xuqi2024/openflexure-microscope/docs/2a_basic_optics_module_zh.md

# 基础光学模块
显微镜光学系统最简单的选择是使用网络摄像头镜头。这是摄影师的老技巧，将广角镜头反向使用作为微距镜头，所以原本指向相机传感器的一侧现在指向样品。因为网络摄像头有非常小的像素，反向使用网络摄像头制作了相当好的显微镜物镜。这个版本的光学模块将树莓派相机变成一个视野约400微米、分辨率约2微米的显微镜。

# 需求
您需要下图中显示的零件：

此步骤所需的零件

## 零件
*   1个[相机平台](./parts/printed/camera_platform.md)
*   1个[镜头延长管](./parts/printed/lens_spacer.md)
*   1个[树莓派相机模块](./parts/electronics/raspberry_pi_camera.md)（理想情况下是v2，尽管v1也应该可以工作） - 您可以用6-LED网络摄像头替代以获得更低成本的解决方案。
*   1个[M3钢螺母](./parts/fixings/m3_steel_nut.md)
*   1个[M3x10mm内六角螺钉](./parts/fixings/m3x8mm_caphead_screw.md)
*   2个[M2x6mm内六角螺钉](./parts/fixings/m2x6mm_caphead_screw.md)

## 工具
*   1个2.5mm内六角扳手
*   1个1.5mm内六角扳手
*   1个手术刀或工艺刀（可选）
*   1个镜头移除工具（相机随附）
*   1个打印的[电路板夹具](./parts/printed_tools/picamera_2_tools.md)

# 组装说明
## 步骤1
首先，获取必要的工具和零件：光学模块塑料零件（镜头间隔器和相机平台）、树莓派相机模块、移除相机镜头的工具、两个M2螺钉来固定相机。根据打印质量，您可能还需要锋利的工艺刀或一些胶带。
 
注意镜头移除工具、电路板夹具和光学模块都特定于您使用的相机。此版本的说明适用于相机板的版本2，树莓派相机模块的版本1也可以工作，但您需要用钳子或镊子移除镜头。相机模块版本2附带镜头移除工具，这是一个中心有孔的白色塑料圆盘。如果可用，这比打印的镜头移除工具更好。

如果您使用6-LED USB网络摄像头（在eBay或AliExpress上约3英镑），您需要跳过其中一些步骤，还要拆解塑料外壳以提取相机的电路板。您可以简单地拧下网络摄像头镜头并将其倒置胶带或粘贴到固定在电路板上的支架上。构建中有6-LED相机的相机平台STL，用它替代树莓派相机平台零件。

## 步骤2
我们需要从相机中移除镜头。为此，您需要两个塑料工具（电路板夹具和镜头移除器）以及相机模块。最好确保您在移除镜头之前已完成到此为止的步骤，以最小化传感器暴露在空气和灰尘中的时间。

> **警告！** 相机板对静电敏感。采取通常的防静电预防措施（理想情况下使用连接到地的防静电腕带，但至少确保在操作相机模块之前触摸接地对象，如金属管道）。

## 步骤3
从相机镜头上移除保护膜。

从镜头上移除保护膜

## 步骤4
有一根小带状电缆连接相机和PCB，很容易断裂。有一个方形塑料夹具适合放在相机和PCB上（"相机板夹具"），防止相机扭转并损坏带状电缆。如图所示将其安装在相机上。请注意，相机板v2的零件多少能适配v1，但您需要更小心，因为它不是完美契合。

电路板夹具
夹住相机以防止带状电缆损坏

## 步骤5
接下来，从相机模块拧下镜头。使用塑料工具夹住镜头模块。这是一个小圆形零件，有四个叉，如图所示适合放在相机板镜头上（仅限版本2）。要移除镜头，将移除工具推到镜头上（只是顶部，有小塑料凸缘的部分）并逆时针转动移除。
 
打印工具只有在叉指向逆时针方向时才有效，所以确保方向正确。重要的是使用电路板夹具固定相机芯片并防止损坏精细的带状电缆。移除镜头后，检查连接相机模块（您拧下镜头的黑色塑料方块）到PCB的小黑色或橙色带状电缆是否仍然连接 - 如果需要，用手指推它重新连接。

移除镜头后，确保将相机面朝下放在桌子上，或在方形黑色镜头支架上贴一条胶带；这将有助于防止灰尘沉积在传感器上，这极难清洁。

镜头移除

## 步骤6
在将零件组装到支架中之前，通过吹一些空气确保其无尘，并检查安装座中央孔中没有塑料丝。

## 步骤7
接下来，将镜头放入塑料延长管中。镜头应该放入时，靠近相机传感器的一侧在上面，面向外的一侧（黑色塑料中有小孔的一侧）面向延长管内。这应该只是推入配合，但可能需要一点力，或需要在镜头周围缠绕一层胶带使其紧密配合（取决于您的打印机）。如果您在镜头周围缠绕胶带，用手术刀或锋利的工艺刀修剪掉伸出镜头上方的任何胶带。

延长管中的镜头



## 步骤8
将延长管安装到相机板上，然后将相机板和延长管放到相机平台上。用两个M2螺钉固定就位，螺钉穿过延长管和相机板，进入平台。如果有的话，您可以使用另外两个M2螺钉使连接更牢固。



## 步骤9
将螺母滑入相机平台侧面的螺母槽中。这可能不需要工具，但您可以使用2.5mm内六角扳手推入。



## 步骤10
将M3螺钉拧入螺母，使其从相机平台侧面伸出。


## 步骤11
做得好 - 您已经组装了光学模块。
