xuqi2024/openflexure-microscope/docs/mount_optics_and_microscope.md

# Mount the optics and the microscope

{{BOM}}

[2.5mm Ball-end Allen key]: parts/tools/2.5mmBallEndAllenKey.md

## Mount the optics {pagestep}






* Get the [2.5mm Ball-end Allen key]{qty:1, cat:tool} ready
* Take the [complete optics module](fromstep){qty:1, cat:subassembly} and pass it through the bottom of the [microscope][microscope with assembled actuators](fromstep){qty:1, cat:subassembly}.
* Insert exposed the mounting screw on the optics module through the keyhole on the z-actuator.






* Insert the Allen key through the teardrop shaped hole on the front of the microscope. Until it engages with the mounting screw.
* Slide optics module up the keyhole as high as it will go.
* Tighten the screw with the Allen key to lock the optics in place.

{{include: mount_microscope.md}}
