xuqi2024/openflexure-microscope/docs/prepare_stand.md

# Prepare the microscope stand

{{BOM}}

[2.5mm Ball-end Allen key]: parts/tools/2.5mmBallEndAllenKey.md
[M3 nut]: parts/mechanical.yml#Nut_M3_SS

## Embed mounting nut in the stand {pagestep}




* Take the [microscope stand][Microscope stand](fromstep){qty:1, cat:printedpart}
* Place an [M3 nut]{qty:4, cat:mech} in the slot under a mounting lug
* Put an [M3x10 cap head screw][extra M3x10 cap screw](parts/mechanical.yml#CapScrew_M3x10mm_SS){qty: 1, cat:tool} into the hole above the nut
* Tighten with a [2.5mm Ball-end Allen key]{qty:1, cat:tool} until you feel reasonable resistance
* Unscrew and remove the screw. The nut should stay mounted.

## Embed remaining mounting nuts in the stand {pagestep}





Repeat the above process for the other three mounting lugs

[prepared microscope stand]{output, qty:1, hidden}
