xuqi2024/openflexure-microscope/docs/high_res_microscope.md

#High-resolution microscope

This is the standard research version of the OpenFlexure Microscope. It supports Standard RMS threaded objectives. It is a fully functioning motorised laboratory grade microscope. For more information on the microscope and its performance [see our paper in Optics Express](https://doi.org/10.1364/BOE.385729).

If you use this microscope for research please consider citing this paper.

Before you start building the microscope you will need to source all the components listed our [bill of materials]{bom}.

The assembly is broken up into several steps:

1. [.](test_your_printer.md){step}
1. [.](printing.md){step, var_type: high_res}
1. [.](solder_led.md){step}
1. [.](prepare_main_body.md){step}
1. [.](prepare_stand.md){step}
1. [.](actuator_assembly.md){step}
1. [.](high_res_optics_module.md){step}
1. [.](mount_optics_and_microscope.md){step}
1. [.](illumination.md){step}
1. [.](motors.md){step}
1. [.](attach_clips.md){step}
1. [.](wiring.md){step}
