xuqi2024/openflexure-microscope/docs/z_motor.md

## Attach the z motor {pagestep}




* Attach the motor to the z-actuator in the same way as they x and y actuators
* Feed the motor cable down the rectangular slot to the left of the actuator.
