xuqi2024/openflexure-microscope/QUICK_START.md

# OpenFlexure显微镜项目快速理解指南

## 🔬 项目是什么？
OpenFlexure显微镜是一个**开源3D打印显微镜项目**，让任何人都能制造高质量的科学显微镜。

## ⭐ 核心特点
- **低成本**: 主要部件为3D打印，成本极低
- **高精度**: 达到亚微米级定位精度（<100nm）
- **模块化**: 可根据需求选择不同的光学系统和功能
- **开源**: 完全开放的硬件和软件设计

## 🎯 适用场景
- **教育**: 学校实验室、科学教育
- **研究**: 生物学、材料学研究
- **医疗**: 基础医疗诊断（特别是发展中国家）
- **业余**: 个人爱好者的科学探索

## 📦 三种配置方案

### 1. 基础版（教育用）💡
- **成本**: ~$100-200
- **光学**: 树莓派相机 + 简单镜头
- **控制**: 手动调节
- **适用**: 学生实验、基础观察

### 2. 标准版（通用）🔧
- **成本**: ~$300-500  
- **光学**: 树莓派相机 + RMS显微镜物镜
- **控制**: 电机自动化
- **适用**: 科研实验、精密观察

### 3. 专业版（研究用）🎯
- **成本**: ~$500-1000
- **光学**: 高质量物镜 + 荧光功能
- **控制**: 全自动化 + 远程控制
- **适用**: 专业研究、医疗诊断

## 🛠️ 制造所需

### 3D打印部件（约200g塑料）
- PLA材料推荐
- 标准FDM打印机即可
- 无需支撑材料

### 电子部件
- 树莓派4B + SD卡
- 树莓派相机模块
- 步进电机（可选）
- LED照明
- 各种螺钉螺母

### 工具
- 基本手工工具
- 螺丝刀套装
- 精密镊子

## 🏗️ 项目结构一览

```
openflexure-microscope/
├── 📁 openscad/           # 3D设计源文件（OpenSCAD）
├── 📁 docs/               # 详细组装说明
├── 📁 build_system/       # 自动构建系统
├── 📄 build.py           # 一键构建脚本
├── 📄 ARCHITECTURE.md    # 详细技术文档
└── 📄 README.md          # 项目说明
```

## 🚀 快速开始

### 1. 获取STL文件
访问 [STL配置器](https://microscope-stls.openflexure.org) 选择配置并下载打印文件

### 2. 3D打印部件
按照 `docs/0_printing.md` 的说明打印所有部件

### 3. 采购电子部件
参考 `docs/0_bill_of_materials.md` 购买所需电子元件

### 4. 组装显微镜
按照 `docs/` 目录中的组装指南逐步组装

### 5. 安装软件
安装树莓派系统和OpenFlexure控制软件

## 🔧 核心技术原理

### 柔性机构
- 不使用传统的轴承和导轨
- 通过塑料的弹性变形实现精密运动
- 无摩擦、无间隙、高精度

### 3D打印一体化
- 复杂的机械结构一次打印成型
- 减少组装工作和成本
- 提高整体结构稳定性

### 模块化设计
- 光学系统可互换
- 支持从网络摄像头到专业物镜
- 可扩展照明、滤光等功能

## 🌐 社区与支持

### 官方资源
- **网站**: [openflexure.org](https://openflexure.org)
- **论坛**: [openflexure.discourse.group](https://openflexure.discourse.group)
- **代码**: [GitLab](https://gitlab.com/openflexure)

### 相关项目
- **控制软件**: OpenFlexure Microscope Server
- **客户端**: OpenFlexure Connect
- **硬件**: Sangaboard电机控制板

## 📚 进一步学习

1. **阅读架构文档**: `ARCHITECTURE.md` - 深入了解技术细节
2. **查看组装视频**: 官网提供详细的组装教程
3. **加入社区**: 论坛和聊天群获取帮助
4. **贡献项目**: 提交改进建议或新功能

## 💡 为什么选择OpenFlexure？

- **经济实用**: 成本是商业显微镜的1/10到1/100
- **性能优异**: 精度达到商业产品水平
- **完全开放**: 可自由修改和定制
- **社区支持**: 活跃的全球开发者社区
- **教育价值**: 在制造过程中学习光学和机械原理

---

这个项目代表了开源硬件在科学仪器领域的一个里程碑，它证明了通过合作和开放可以让先进的科学工具普及到世界各地。
