xuqi2024/openflexure-microscope/docs/_navigation_zh.md

# OpenFlexure显微镜中文文档导航

## 组装指南
1. [主页](./index_zh.md) - 项目介绍和总览
2. [材料清单](./0_bill_of_materials_zh.md) - 获取非打印零件
3. [打印零件](./0_printing_zh.md) - 3D打印指南和设置
4. [致动器组装](./1_actuator_assembly_zh.md) - 组装运动机制
5. [基础光学模块](./2a_basic_optics_module_zh.md) - 网络摄像头光学系统
6. [照明系统](./3_illumination_zh.md) - 透射照明组装

## 待翻译文档
- `2b_high_resolution_optics_module.md` - 高分辨率光学模块
- `3b_illumination_reflection.md` - 反射照明
- `4_clips_and_wiring.md` - 样品夹具和布线
- `5_motors.md` - 电机安装
- `6_motor_controllers.md` - 电机控制板

## 英文原版文档
如需查看英文原版，请参考 `docs/` 目录下对应的文件。

## 构建类型选择

### 基础版本（教育用）
- 使用 `2a_basic_optics_module_zh.md` 中的说明
- 适合学校和业余爱好者
- 成本最低，分辨率约2微米

### 高分辨率版本（研究用）  
- 使用高分辨率光学模块（待翻译）
- 适合科学研究和医疗应用
- 需要显微镜物镜和管镜

### 电机化版本
- 在基础版本基础上添加电机系统
- 支持自动控制和远程操作
- 需要额外的电机和控制板

## 帮助和支持
- [GitHub仓库](https://github.com/rwb27/openflexure_microscope)
- [官方论坛](https://openflexure.discourse.group/)
- [官方网站](https://openflexure.org/)

---
*这些中文文档是英文原版的翻译，如有疑问请以英文原版为准。*
