xuqi2024/openflexure-microscope/docs/0_bill_of_materials_zh.md

# 获取非打印零件
确保在开始之前您拥有所有必要的零件和工具。所有零件都应在下面的材料清单中列出，目前这个清单仍在完善中（最终将自动生成，这应该有助于保持准确性）。我们建议通读所有说明并检查此处显示的数量是否正确相加，直到自动生成功能正常工作。打印零件在[下一节](./0_printing_zh.md)中描述。

## 固定硬件：
*   3x [M3x25mm六角头螺钉](./parts/fixings/m3x25mm_hexagonhead_screw.md)，不锈钢
*   3x [M3黄铜螺母](./parts/fixings/m3_brass_nut.md)
*   1x [M3钢螺母](./parts/fixings/m3_steel_nut.md)（使用黄铜也可以）
*   8x [M3不锈钢垫圈](./parts/fixings/m3_washer.md)
*   3-14x [M3x8mm内六角螺钉](./parts/fixings/m3x8mm_caphead_screw.md)（有些是可选的，用于样品夹具和样品升高器，但您至少需要三个）
*   2-4x [M2x6mm内六角螺钉](./parts/fixings/m2x6mm_caphead_screw.md)
*   6x [M4x6mm盘头螺钉](./parts/fixings/m4x6mm_buttonhead_screw.md)（可选，用于电机）
*   3x [氟橡胶O型圈，30x2mm](./parts/fixings/viton_o_ring_30mm_inner_diameter_2mm_cross_section.md)（注意：多准备一些备用件！）

## 电子零件：
*   [5mm白色LED](./parts/electronics/white_led.md)
*   [60欧姆电阻](./parts/electronics/60_ohm_resistor.md)
*   [多股电线](./parts/electronics/stranded_wire.md)
*   [2路JST接头连接器](./parts/electronics/2_way_jst_header.md)（只要您有办法点亮LED，具体类型并不重要）
*   [树莓派相机模块](./parts/electronics/raspberry_pi_camera.md)（v2版本，虽然v1版本也可以）
*   [树莓派](./parts/electronics/raspberry_pi.md)（配套电源、键盘、显示器等）
*   3x [28BYJ-48微型步进电机](./parts/electronics/stepper_motors.md)（可选）
*   上述电机的[电机驱动板](./parts/electronics/motor_driver.md)（可选）

## 光学零件：
*   [13mm直径，5mm焦距塑料聚光镜](./parts/optics/condenser_lens.md)（可选，强烈推荐用于高分辨率光学系统）
*   [12.7mm直径，50mm焦距消色差透镜](./parts/optics/tube_lens.md)（仅用于高分辨率光学系统）
*   [RMS螺纹，有限共轭显微镜物镜](./parts/optics/objective.md)（仅用于高分辨率光学系统）

## 工具：
*   2.5mm内六角扳手
*   1.5mm内六角扳手（用M2螺钉固定相机时使用）
*   胶带（电工胶带或PTFE水管工胶带效果很好，尽管普通胶带也可以）
*   锋利的工艺刀（用于修剪胶带和清理打印件）
*   3mm钻头配手摇钻夹头（如果您自己打印零件并需要扩大孔径）
*   尖嘴钳（可选，但很有用 - 特别适合清理打印件）

不要忘记树莓派、相机模块和相关的屏幕、电源、SD卡、键盘、鼠标等（我没有明确列出这些，但运行树莓派需要它们）。另外，如果您使用高分辨率光学模块或想要添加电机，您将需要额外的零件。

在等待您订购的零件到达时，为什么不尝试下一节关于[打印塑料零件](./0_printing_zh.md)的内容呢。
