xuqi2024/openflexure-microscope/docs/parts/materials/black_pla_filament.md

# Black PLA filament

Certain parts specifically require black filament [(more information)](../../info_pages/why_optics_black.md).
