xuqi2024/openflexure-microscope/docs/parts/tools/2.5mmBallEndAllenKey.md

# 2.5 mm Ball-end Allen Key

It is important that the Allen key has a ball end:
