xuqi2024/openflexure-microscope/rendering/librender/render_settings.scad

function extras_colour() = "DodgerBlue";
function tools_colour() = "MediumAquamarine";
function body_colour() = "WhiteSmoke";
function remove_colour() = "Red";
function optics_module_colour() = "#404040";
function stand_colour() = "#404040";
