xuqi2024/openflexure-microscope/openscad/upright_z_actuator_mount.scad

//Builds a z-spacer to be used with a sample of negligible thickness
use <./libs/microscope_parameters.scad>
use <./libs/upright_z_axis.scad>

upright_z_spacer(default_params(), 1);
