xuqi2024/openflexure-microscope/openscad/accessories/picamera_2_lens_gripper.scad

// this file just pulls out one module from picamera_2

use <../libs/cameras/picamera_2.scad>

picamera_2_lens_gripper();
