xuqi2024/openflexure-microscope/openscad/camera_platform.scad

use <./libs/microscope_parameters.scad>
use <./libs/lib_optics.scad>
use <./libs/optics_configurations.scad>

camera_platform_stl();

module camera_platform_stl(){
    params = default_params();
    optics_config = pilens_config();

    camera_platform(params, optics_config, 5);
}
