xuqi2024/openflexure-microscope/openscad/fl_cube.scad

use <./libs/lib_fl_cube.scad>

fl_cube();
