xuqi2024/openflexure-microscope/openscad/gears.scad

/******************************************************************
*                                                                 *
* OpenFlexure Microscope: Gears for actuators                     *
*                                                                 *
* This is part of the OpenFlexure microscope, an open-source      *
* microscope and 3-axis translation stage.  It gets really good   *
* precision over a ~10mm range, by using plastic flexure          *
* mechanisms.                                                     *
*                                                                 *
* (c) Richard Bowman, January 2016                                *
* Released under the CERN Open Hardware License                   *
*                                                                 *
******************************************************************/

use <MCAD/involute_gears.scad> // forward slash - for platform independence
use <utilities.scad>

//pi=3.14159;
//$fn=32;
strut_t=3;
depth = 40;
ratio = 2;
teeth_smallgear = 12;
teeth_biggear = teeth_smallgear * ratio;
c2c_distance = 20; //see output from motor_lugs
pitch = c2c_distance * 360 / (teeth_smallgear + teeth_biggear);


function gear_c2c_distance() = c2c_distance;
function gear_ratio() = ratio;
function small_gear_spacing() = c2c_distance/(ratio + 1)*2 + 4;
function large_gear_spacing() = c2c_distance/(1/ratio + 1)*2 + 4;
function thumbwheel_spacing() = 44;

//pitch radius = Nteeth * circular_pitch / 360
//pitch radius is centre of gear to meshing point
//outer radius = pitch radius * (1 + 2*pi/Nteeth)
//our c2c distance is 10+12.5mm=22.5mm,
module large_gear(){
	assign($fn=32, pi=3.14159, pitch_r=c2c_distance*(ratio/(ratio+1)))
	difference(){
		intersection(){
			gear(number_of_teeth=teeth_biggear,
				circular_pitch=pitch,
				circles=0,
				gear_thickness=6,
				hub_thickness=6,
				hub_diameter=20,
				rim_thickness=6,
				bore_diameter=1);	
			cylinder(r1=pitch_r-2,r2=pitch_r+18,h=20); //stop bottoms of teeth being funny
		}
		translate([0,0,1.5]) nut(3,shaft=true,fudge=1.2,h=999);
	}
}

module small_gear(){	
	$fn=32;
    pi=3.14159;
    h=8;
    flat_h=h-3.5;
    shaft_r=5/2*1.1;
    pitch_r=c2c_distance*1/(ratio+1);
	difference(){
		union(){
			gear(number_of_teeth=teeth_smallgear,
					circular_pitch=pitch,
					circles=0,
					gear_thickness=h,
					hub_thickness=h,
					hub_diameter=1,
					rim_thickness=h,
					bore_diameter=1);
				
			cylinder(r=pitch_r+pi*pitch_r/teeth_smallgear,h=0.5); //help adhesion
		}
        //cut-out for motor shaft
		intersection(){
			cylinder(r=shaft_r, h=999, center=true);
			sequential_hull(){
                translate([0,0,-tiny()]) cube([999,3,tiny()]*1.1,center=true);
                translate([0,0,flat_h]) cube([999,3,tiny()]*1.1,center=true);
                translate([0,0,flat_h+2]) cube([999,7,tiny()]*1.1,center=true);
                translate([0,0,999]) cube([999,7,tiny()]*1.1,center=true);
            }
		}
        //chamfer the top/bottom for better fit
        translate([0,0,h]) cylinder(r1=shaft_r,r2=shaft_r+2,h=2,center=true);
        translate([0,0,0]) cylinder(r2=shaft_r,r1=shaft_r+2,h=2,center=true);
	}
}



module thumbwheel(r=10,h=5,knobble_r=1,knobble_angle=45,chamfer=0.5){
    lobe_r = 10;
    lobe_h = 5;
    base_low_r = 10;
    base_up_r = 12;
    base_h = 12.5;
    n_lobe = 6;

    difference()
    {
        union()
        {
            cylinder(r1=base_low_r,r2=base_up_r,h=base_h);
            for( n = [0 : n_lobe-1] )
            {
                deg = 360*n/n_lobe;
                translate([lobe_r*sin(deg),lobe_r*cos(deg),base_h]){cone_cyl(r=lobe_r,h=lobe_h);}
            }
        }
        translate([0,0,1.5]) nut(3,shaft=true,fudge=1.2,h=999);
    }

    module cone_cyl(r=5,h=5)
    {
        cylinder(r=r,h=h);
        translate([0,0,-h]){cylinder(r1=.1,r2=r,h=h);}
    }
}

module motor_clearance(h=15){
    // an approximate cut-out for a 28BYJ-48 stepper motor
    // NB does not include cable clearance, I assume that goes on the outside.
    // The centre of the body is at the origin, NB this is NOT the shaft location.
    // The shaft is not included.
    linear_extrude(height=h){
        circle(r=14+1.5);
        hull() reflect([1,0]) translate([35/2,0]) circle(r=4.5);
    }
    reflect([1,0,0]) translate([35/2,0,0]) rotate(180) trylinder_selftap(4,h=20,center=true);
}

module motor_and_gear_clearance(gear_h=10, h=999){
    // clearance for the small gear, large gear, and motor.
    // It's positioned with the centre of the large gear at the origin.
    // NB gear_h should match the height of the motor lugs above the
    // flat surface for the large gear, in motor_lugs in compact_nut_seat.scad.
    linear_extrude(h) offset(1.5) hull() {
        projection() large_gear();
        translate([0,c2c_distance]) projection() small_gear();
    }
    translate([0,c2c_distance-7.8,gear_h]) motor_clearance(h=h-gear_h);
}

repeat([0,large_gear_spacing(),0],3,center=true) large_gear();
