xuqi2024/openflexure-microscope/openscad/illumination_thumbscrew.scad

use <./libs/gears.scad>

illumination_thumbscrew();
