xuqi2024/openflexure-microscope/openscad/led_array_holder.scad

use <./libs/illumination.scad>
use <./libs/utilities.scad>
use <./libs/locking_dovetail.scad>

module led_array_holder(){
    // adafruit 3444 LED array
    led_array_l = 36;
    led_array_w = 25.5;

    dt_block_depth = 16; //thickness of the dovetail (16mm is enough)
    dt_height = 15; // height of the clamp (~15mm is tall enough, lower and it
                    // gets harder to ensure it is horizontal as it can twist).
    dt_params = dovetail_params(
        width=illumination_dovetail_w(),
        height=dt_height,  // do we want to keep this so tall?  It would probably be fine if we made it shorter.
        block_depth = dt_block_depth,
        taper_block = false
    );


    difference(){
        union(){
            hull(){
                translate([0,-2.5/2,4/2]){
                    minkowski(){
                        cube([led_array_l-4,led_array_w-4,4], center = true); // bottom of the holder
                        cylinder(r=2,h=1);
                    }
                }
                translate_y(illumination_dovetail_y()){
                    linear_extrude(dt_height){
                        back_of_block_2d(dt_params);
                    }
                }
            }
            // the dovetail clip
            translate_y(illumination_dovetail_y()){
                dovetail_clamp_m(dt_params);
            }
        }
        // the hole for wires/heat
        translate_z(1/2){
            minkowski(){
                cube([led_array_w-2,led_array_w-2,999], center = true); //the hole for the LED array
                cylinder(r=1,h=1);
            }
        }
        //screw holes
        repeat([led_array_w + (led_array_l - led_array_w)/2, 0, 0], 2, center=true){
            repeat([0, led_array_w - (led_array_l - led_array_w)/2, 0], 2, center=true){
                trylinder_selftap(2.5,h=999, center=true);
            }
        }
    }

}

led_array_holder();
