xuqi2024/openflexure-microscope/openscad/cameras/picamera_2_cover.scad

// this file just pulls out one module from picamera_2

use <./picamera_2.scad>

picamera_2_cover();
