xuqi2024/openflexure-microscope/(list of files, cad)

Other CAD files:
openscad/seperate_z_actuator.scad
openscad/accessories/actuator_drilling_jig.scad
openscad/large_gears.scad
openscad/lens_holder_thinner.scad
openscad/main_body.scad
openscad/upright_large_gears.scad
rendering/librender/optics.scad
rendering/librender/render_utils.scad
rendering/librender/rendered_components.scad
rendering/librender/rendered_main_body.scad
rendering/librender/tools.scad
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
