xuqi2024/openflexure-microscope/docs/upright_actuator_assembly.md

## Repeat this process for separate z-actuator {pagestep}

[Separate z-actuator][prepared separate z-actuator](fromstep){qty:1, cat:subassembly}. Once complete the [complete separate z-actuator]{output, qty:1} should look like this:
