xuqi2024/openflexure-microscope/openscad/test_pieces/README.md

# Test pieces

This directory contatins a number of test pieces which can be used to check that your printer is able to print the most complicated structures in the microscope without having to print a whole microscope.
