xuqi2024/openflexure-microscope/(commit log)

2019-06-26 Replace motor_driver_case.scad
2019-06-26 Replace microscope_stand.scad
    [microscope_stand.scad]
2019-07-31 Added support for Range Tour Dashcam
    [camera.scad, range_tour_dashcam.scad]
2019-08-10 Made bucket more flexible
    [microscope_stand.scad, uc2_connector.scad]
2020-06-23 Thinner lens holder for condenser lens
    [lens_holder_thinner.scad]
2020-06-23 Move lens_holder_thinner.scad
    [lens_holder_thinner.scad]
2020-06-23 LED collimator illumination, using Pi lens and 13mm lens
    [LED_collimator.scad]
2020-08-12 option to rotate the beamsplitter cutout for the delta stage
    [microscope_parameters.scad, optics.scad]
2020-08-12 rotating the fl_cube_casing if using the delta stage
    [optics.scad]
2020-08-13 Neater way of parameterising the rotation
    [optics.scad]
2020-08-13 Added rotation for camera mount for delta stage
    [optics.scad]
2020-09-14 Add prebuilt stl files for 6led webcam and dashcam
    [6ledcam_mount_bottom.stl, 6ledcam_mount_top.stl, dashcam_mount_thread.stl, dashcam_mount_top.stl]
2020-09-14 Tweak stl copying build system stuff
2020-09-14 Add just_leg_test.stl
    Fixes #160
    [just_leg_test.stl]
2020-09-14 Make sure to register dashcam and 6led lenses in build
2020-10-05 Fix lens lists in build
2020-10-12 Remove "no riser" requirement for camera platform stls
2020-10-12 Put prebuilt_stl_files into git lfs
    [6ledcam_mount_bottom.stl, 6ledcam_mount_top.stl, dashcam_mount_thread.stl, dashcam_mount_top.stl, just_leg_test.stl]
2020-10-12 Actually use git lfs to track the stl files?
2020-10-12 Explicitly add stl files to git lfs
2020-10-12 Make gitlab ci checkout stl files from lfs
2020-10-12 Add prebuilt_stl_files
    [6ledcam_mount_bottom.stl, 6ledcam_mount_top.stl, dashcam_mount_thread.stl, dashcam_mount_top.stl, just_leg_test.stl]
2020-10-12 Fix just_leg_test.stl copy
2020-10-13 Properly configure stl selection for camera platform
2020-10-13 Unify dashcam and 6ledcam bottom
    [dashcam_and_6ledcam_mount_bottom.stl, dashcam_mount_thread.stl]
2020-10-13 Use openflexure-microscope-extra instead of git lfs
    [6ledcam_mount_top.stl, dashcam_and_6ledcam_mount_bottom.stl, dashcam_mount_top.stl, just_leg_test.stl]
2020-10-28 Added a module to make the nut trap, slot and shaft
    [compact_nut_seat.scad]
2020-10-28 Changed stage thickness to allow nut trap, modified parameters
    Major paramter changes:
    * `sample_z` renamed to `nominal_height`. This is the height at the top of the leg
    * new parameter `sample_height` sets sample height.
    * `leg_block_t` is the thickness of the blocks at top and bottom of legs (was equal to `sample_t`)
    * `stage_t` - now calculated from `nominal_height` `sample_height` and `leg_block_t`
    `nominal height` was created as `sample_z` was used extensively though the code in places that
    should not change if the riser is incorporated into the main body.
    Need to change the patform for the low cost microscope
    [back_foot.scad, illumination.scad, lens_spacer.scad, main_body.scad, microscope_parameters.scad, optics.scad, optics_assembly.scad, z_axis.scad]
2020-10-28 Added a test object for the nut trap
    [just_nut_trap_test.scad]
2020-10-29 Increased height of nut trap test to allow M3x8 screw to be used to pull in nut
    [just_nut_trap_test.scad]
2020-10-29 Moved the XY stage into its own function
    [main_body.scad, microscope_parameters.scad, sample_riser.scad]
2020-10-29 New slide riser now sample riser is integrated
    [slide_riser.scad]
2020-11-11 fixing crazyness with lens spacer
    lens spacer spacing was set based on sample_z and the z_axis flexure height
    and went crazy if these were changed. Now the lens spacer height is set. The
    z position on the spacer is calculated drom sample_z and parfocal distance.
    The camera platform height is then calculated from the spacer distance
    [camera_platform.scad, illumination.scad, lens.scad, lens_spacer.scad, main_body.scad, microscope_parameters.scad, optics.scad, optics_assembly.scad]
2020-11-11 Fix typo in camera platform
    [camera_platform.scad]
2020-11-11 Optics modules based on sample_z again. Parfocal changed to 45. Trylinder optics modules not checked
    [optics.scad]
2020-11-12 Fixing build of cameral platform and slide riser
2020-11-12 Adding the nut trap test object to build script
2020-11-12 Fix build bug, remove extra motor case, set main body defaults
    [microscope_parameters.scad]
2020-11-12 Not generating stl options or including extra files while playing with the options
2020-11-12 Reinforce bridge over reflection illumination. Remove old illumination dovetail
    [gears.scad, main_body.scad, microscope_parameters.scad, wall.scad]
2020-11-12 Improving naming consistency of illumination dovetail
    [dovetail.scad, illumination.scad, illumination_dovetail.scad, microscope_parameters.scad, z_axis.scad]
2020-11-12 Removing tall feet and back feet
    [back_foot.scad, microscope_parameters.scad]
2020-11-12 Removing obsolete sample riser and updating readme
    [sample_riser.scad]
2020-11-12 Improve slide riser comments
    [slide_riser.scad]
2020-11-12 Remove old optics configuratons
    [optics.scad]
2020-11-12 !! Fixing the broken reflection cutout on stand
    Issues introduced in v6.1.3 broke:
    * changing the height of the bucket base
    * the no-pi bucket base
    * The beamsplitter bucket base
    Also added -hardwarnings parameter to the build script
    [microscope_parameters.scad, microscope_stand.scad]
2020-11-12 Generating STL options again
2020-11-13 Ensuring light traps have at least one cone to stop divide by 0 warnings.
    [utilities.scad]
2020-11-13 Terrifyingly large clean up of ninja build system started
    [microscope_stand.scad]
2020-11-17 Separated STL generate and copy from Writer functionality
2020-11-19 LED array holder
    [LED_array_holder.scad]
2020-11-22 Fixes over-enthusiastic cutout in xy-base.
    [main_body.scad]
2020-11-22 Split xy positioning system into separate module.
    [main_body.scad]
2020-11-22 Remove endstop change awaiting feedback on !187
    [main_body.scad]
2020-11-22 replacing d with tiny() to avoid confusion with diameter.
    [actuator_assembly_tools.scad, actuator_drilling_jig.scad, camera_platform.scad, fl_cube.scad, illumination.scad, lens_spacer.scad, main_body.scad, microscope_parameters.scad]
2020-11-22 Commit extra file missed last time
    [z_axis.scad]
2020-11-22 Improved central_optics_cut_out.
    [main_body.scad]
2020-11-22 Unifying way flexures are refered to, changing leg so there is not a variable and module with same name
    [compact_nut_seat.scad, main_body.scad, microscope_parameters.scad, microscope_stand.scad, wall.scad, z_axis.scad]
2020-11-23 Removed duplicated utility modules.
    [utilities.scad]
2020-11-23 Added boltholes to lugs and moved them to xy_positioning
    [main_body.scad]
2020-11-23 Clean up hole naming, stop cutting the hole twice on the lugs. Fix base cutout for stand
    [main_body.scad, microscope_parameters.scad, microscope_stand.scad]
2020-11-23 Moving over to dot notation indexing for [x,y,z] vectors
    [actuator_assembly_tools.scad, band_insertion_cutaway.scad, compact_nut_seat.scad, dovetail.scad, feet.scad, fl_cube.scad, illumination.scad, illumination_dovetail.scad]
2020-11-23 Fixed two partialy reverted indexing changes
    [dovetail.scad]
2020-11-23 Further modularisation of main body
    [main_body.scad]
2020-11-23 Further modularising XY positioning
    [main_body.scad]
2020-11-23 Ooops, Didn't save all changes.
    [main_body.scad]
2020-11-24 More cleanup of main_body.scad
    [main_body.scad, microscope_parameters.scad]
2020-11-24 tidy up of stray whitespace and semicolons
    [1_inch_disc_holder.scad, 6led.scad, actuator_assembly_tools.scad, actuator_drilling_jig.scad, actuator_tension_band.scad, band_insertion_cutaway.scad, bottom_of_main_body.scad, camera.scad]
2020-11-24 Cleaned up and commented tall_condenser.
    [illumination.scad]
2020-11-24 Refactored stl options to move towards questionnaire
2020-11-24 Cleaning up z-azis code a bit and moving in z assembly
    [main_body.scad, z_axis.scad]
2020-11-25 Align cutouts with original part.
    [illumination.scad]
2020-11-25 Fixed erroneously named tall_condenser_new
    [illumination.scad]
2020-11-25 Honour the endstops flag
    [main_body.scad]
2020-11-25 Split up condenser. clean up illumination positioning code
    [condenser.scad, illumination.scad, illumination_dovetail.scad, microscope_parameters.scad, z_axis.scad]
2020-11-25 Fixing variable typo
    [illumination.scad]
2020-11-25 Moved cyl_slot module to utilities
    [illumination.scad, utilities.scad]
2020-11-25 Condenser lens can be set by arguments
    [condenser.scad, illumination.scad]
2020-11-26 Modularising illumination dovetail
    [illumination.scad, illumination_dovetail.scad]
2020-11-26 Fixed edge case uniqueness test where element in list matches sublist with matching first element
2020-11-27 Starting to move to dictionaries
    [illumination.scad, illumination_dovetail.scad, main_body.scad, main_body_transforms.scad, microscope_parameters.scad, microscope_stand.scad, microscope_stand_no_pi.scad, motor_driver_case.scad]
2020-11-27 Moving more things into dictionary. Not fully tested
    [camera_platform.scad, feet.scad, illumination.scad, illumination_dovetail.scad, lens_spacer.scad, main_body.scad, main_body_transforms.scad, microscope_parameters.scad]
2020-11-27 Fixing some things that got missed in refactor
    [camera_platform.scad, illumination.scad, just_leg_test.scad, microscope_stand.scad, microscope_stand_no_pi.scad, motor_driver_case.scad, optics.scad, slide_riser.scad]
2020-11-27 Few more things move to functions
    [compact_nut_seat.scad, feet.scad, illumination.scad, main_body.scad, microscope_parameters.scad, microscope_stand.scad, z_axis.scad]
2020-11-30 Parameterise condenser angle
    [condenser.scad, illumination.scad, microscope_parameters.scad]
2020-11-30 Fix optics rendering and colourise
    [optics_assembly.scad]
2020-11-30 Make CI render optics assembly
2020-11-30 Updated band cutaway render and added to build script
    [band_insertion_cutaway.scad, optics_assembly.scad]
2020-12-01 Colour fix
    [band_insertion_cutaway.scad]
2020-12-01 Main body cutouts, main body renders and fixing more use of d for tiny()
    [actuator_assembly_tools.scad, compact_nut_seat.scad, feet.scad, fl_cube.scad, main_body.scad, optics.scad, picamera_2.scad, utilities.scad]
2020-12-01 Removed the last of the little ds
    [6led.scad, dovetail.scad, gears.scad, logitech_c270.scad, m12.scad, microscope_parameters.scad, picamera_2.scad, utilities.scad]
2020-12-01 Seperate out ties so they can be rendered seperatly
    [compact_nut_seat.scad, main_body.scad, microscope_parameters.scad, z_axis.scad]
2020-12-01 Render of brim and ties that need removing
    [brim_and_ties.scad]
2020-12-01 Reorganising renders into top level
    [band_insertion_cutaway.scad, brim_and_ties.scad, compact_nut_seat.scad, optics_assembly.scad]
2020-12-01 Fix issues with feet introduced by removing some of the extra 9s
    [feet.scad, optics.scad, picamera_2.scad, utilities.scad]
2020-12-02 Rename weird parameters and document thread module
    [optics.scad, optics_assembly.scad, thorlabs_threads.scad]
2020-12-02 Making a little library for rendering
    [band_insertion_cutaway.scad, hardware.scad]
2020-12-02 Fix licensing on thread file after confirming with HazenBabcock
    [thorlabs_threads.scad]
2020-12-03 Adding some hardware components
    [hardware.scad]
2020-12-03 Moving to a consistent internal version of MCAD gears. Fixed depreciations
    [gears.scad, involute_gears.scad]
2020-12-03 Starting to restructure into libraries
    [actuator_assembly_tools.scad, actuator_drilling_jig.scad, actuator_tension_band.scad, band_insertion_cutaway.scad, bottom_of_main_body.scad, brim_and_ties.scad, camera_platform.scad, compact_nut_seat.scad]
2020-12-03 Fix some import and filename typos during reorganisation
    [large_gears.scad, picamera_2_cover.scad]
2020-12-03 Moved a few more things to libs
    [actuator_assembly_tools.scad, actuator_drilling_jig.scad, band_insertion_cutaway.scad, bottom_of_main_body.scad, brim_and_ties.scad, camera_platform.scad, condenser.scad, feet.scad]
2020-12-03 moved endstops to libs
    [feet.scad]
2020-12-04 Fix import paths for LED array holder
    [LED_array_holder.scad]
2020-12-04 Fluorescent cube with 3mm space for emission filter
    [fl_cube_3mm_emission.scad]
2020-12-04 The components to attach to the filter cube for fluorescent reflection illumination, used with LZ1 LED
    [reflection_illuminator_FL_LED_star.scad]
2020-12-04 Move screw holes up to top of fl cube
    [optics.scad]
2020-12-04 Fix rotation
    [optics.scad]
2020-12-04 Reduce size of screw holes
    [optics.scad]
2020-12-04 Increase size of faceplate
    [optics.scad]
2020-12-04 Fluorescent cub with 3mm space for emission filter
    [fl_cube_3mm_emission.stl]
2020-12-04 Revert "Fluorescent cub with 3mm space for emission filter"
    This reverts commit ae1828cef7f7548005e64e6f843024c3aec43fc8
    [fl_cube_3mm_emission.stl]
2020-12-04 Correct rotations
    [optics.scad]
2020-12-04 Screw holes and cutouts for swapable reflection illuminator
    [optics.scad]
2020-12-04 Change LED height
    [reflection_illuminator_FL_LED_star.scad]
2020-12-04 Add slip plate
    [reflection_illuminator_FL_LED_star.scad]
2020-12-04 Add screw holes for attachment to optics unit
    [reflection_illuminator_FL_LED_star.scad]
2020-12-04 Fix variables
    [optics.scad]
2020-12-04 remove testing variables
    [optics.scad]
2020-12-04 Fix reflect in fl_screw_holes
    [optics.scad]
2020-12-04 increase size of slip plate holes
    [reflection_illuminator_FL_LED_star.scad]
2020-12-04 Move the slip plate screw holes up to top of filter cube
    [reflection_illuminator_FL_LED_star.scad]
2020-12-04 Reduce depth of slip plate lugs
    [reflection_illuminator_FL_LED_star.scad]
2020-12-04 reduce gap between slip plate lugs
    [optics.scad, reflection_illuminator_FL_LED_star.scad]
2020-12-04 adjust faceplate shape
    [optics.scad]
2020-12-04 increase the space of the cutout
    [optics.scad]
2020-12-04 Clean up and reorganising the objective
    [optics.scad]
2020-12-04 Tweak the position of the filter cube
    [optics.scad]
2020-12-04 Only need one mount now
    [reflection_illuminator_FL_LED_star.scad]
2020-12-04 Simplify and improve fl cube mount
    [reflection_illuminator_FL_LED_star.scad]
2020-12-04 Add nut trap to lens holder
    [reflection_illuminator_FL_LED_star.scad]
2020-12-04 Variable rename and tidy
    [reflection_illuminator_FL_LED_star.scad]
2020-12-04 Slip plate filter cube limit improvements
    [reflection_illuminator_FL_LED_star.scad]
2020-12-04 Slot for excitation filter
    [reflection_illuminator_FL_LED_star.scad]
2020-12-04 Tidied main module
    [reflection_illuminator_FL_LED_star.scad]
2020-12-04 Move the beamsplitter down a little more
    [optics.scad]
2020-12-04 Rejig of the camera mount parts to better fit the reflection illumination. Split up the main tube and the dovetail to remove weird geometries. Now works for combinations of delta stage/standard/BS/no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
    [optics.scad]
2020-12-04 CorrectLED screw locations
    [reflection_illuminator_FL_LED_star.scad]
2020-12-04 Improve the mounting holes for the slip plate to optics module.
    [reflection_illuminator_FL_LED_star.scad]
2020-12-04 fluorescence is type of beamsplitter so use beamsplitter instead
    [optics.scad]
2020-12-04 increase extra space
    [reflection_illuminator_FL_LED_star.scad]
2020-12-04 Increase the size of the mounting point to the optics module
    [reflection_illuminator_FL_LED_star.scad]
2020-12-04 Increase the extra space
    [reflection_illuminator_FL_LED_star.scad]
2020-12-04 Improved arrangement of the optics tube elements by moving out the beamsplitter
    [optics.scad]
2020-12-04 Fix some rebase errors
    [reflection_illuminator_LED_star.scad]
2020-12-04 Improve params for excitation
    [reflection_illuminator_LED_star.scad]
2020-12-04 Readjust the extra space
    [reflection_illuminator_LED_star.scad]
2020-12-04 Slight adjustment as the center of the fl cube is not actually the center
    [reflection_illuminator_LED_star.scad]
2020-12-04 better parameterisation
    [reflection_illuminator_LED_star.scad]
2020-12-04 Fix rebase errors
    [optics.scad]
2020-12-04 rebase fixes
    [reflection_illuminator_LED_star.scad]
2020-12-04 fix some bugs introduced in the manual rebase fix
    [optics.scad, reflection_illuminator_LED_star.scad]
2020-12-04 Add LED-star illuminator to build script
2020-12-09 Fix changed dictionary location and variable name in renders
    [band_insertion_cutaway.scad, optics_assembly.scad]
2020-12-09 Starting to render assembly of actuators
    [actuator_assembly.scad, band_insertion_cutaway.scad, hardware.scad]
2020-12-09 Exploded renders of lead screw assembly
    [actuator_assembly.scad, render_utils.scad]
2020-12-09 Added actuator assembly steps
    [actuator_assembly.scad, brim_and_ties.scad, hardware.scad, render_utils.scad]
2020-12-10 Reorganise rendering and finish actuators
    [actuator_assembly.scad, assembly_parameters.scad, band_insertion_cutaway.scad, brim_and_ties.scad, hardware.scad, optics_assembly.scad, render_settings.scad, render_utils.scad]
2020-12-10 Adjusting render angle for ties and fixing file name for assembled actuators
2021-02-04 Remove uneeded hole on sides of feet. Plus minor clean up
    [feet.scad]
2021-02-11 Rendering picamera and improved optics
    [electronics.scad, optics.scad, optics_assembly.scad, prepare_picamera.scad, render_utils.scad]
2021-02-11 Use picamera in optics assembly renders
    [electronics.scad, lens_tool.scad, optics.scad, optics_assembly.scad, prepare_picamera.scad, render_settings.scad]
2021-02-11 Fix lens tool
    [lens_tool.scad]
2021-02-12 Actually fix lens tool
    [lens_tool.scad]
2021-02-12 Moving cutaway function to the render utils
    [optics_assembly.scad, render_utils.scad]
2021-02-12 Annotated renders, fix optics module shape, new lens assembly renders
    [lens_tool.scad, optics_assembly.scad, render_utils.scad]
2021-02-13 Single annotated image for lens pushfit
2021-02-13 Render of condenser lens assembly
    [optics_assembly.scad]
2021-02-13 split optics renders, render objective and camera assembly
    [optics_assembly.scad, render_utils.scad, rendered_components.scad, rms_optics_assembly.scad]
2021-02-13 Improved render of objective
    [optics.scad, rms_optics_assembly.scad]
2021-02-13 Fix objective assembly renders
2021-02-14 Render of optics module mount screw assmbly
    [optics_assembly.scad, rms_optics_assembly.scad]
2021-02-14 Fix objective assembly render
    [rms_optics_assembly.scad]
2021-02-14 Added module to render motors
    [electronics.scad]
2021-02-16 Rendering of motor wire and connector
    [electronics.scad, render_utils.scad]
2021-02-16 First pass on cable mangement for wires
    [cable_management.scad]
2021-02-18 Removed cantilevered structure for motor wrap around
    [cable_management.scad]
2021-02-20 swapped in new dovetail and got it working
    The old dovetail is, I think, now only needed for illumination.
    Optics.scad should build without it, and my one quick test
    suggests it does.
    I've replaced the new-style lookup with key_lookup calls, and reverted my
    name changes for utilities.scad.
    [optics.scad]
2021-02-22 Support and strength
    There is now more material in front of the nut, for strength.
    There's also a bridge between the flexure and the clamp,
    as previously this was printed as a cantilever.
2021-02-22 First working condenser with the new dovetail
    I've not printed this yet, but it looks ready for a test print.
2021-02-22 Rendered the illumination dovetail
    Rendering the dovetail reveals that it needs to be taller to
    work with the new condenser design.
    I've made this change.
    [illumination_assembly.scad, illumination_dovetail.scad]
2021-02-23 Use a shallower dovetail clamp
    In order to clear the sample clips it makes sense for
    the illumination to hang down
2021-02-23 Add cable housing to xy actuators
    [main_body.scad]
2021-02-25 Cable housing height no longer ad-hoc, took some serious code tidying
    [actuator_drilling_jig.scad, assembly_parameters.scad, band_insertion_cutaway.scad, cable_management.scad, main_body.scad]
2021-02-25 x-y cable cap updated
    [cable_management.scad, main_body.scad]
2021-02-25 Fix drilling jig
    [actuator_drilling_jig.scad]
2021-02-26 front housing for z cables
    [cable_management.scad, main_body.scad]
2021-02-26 fix printing poistion of z cable tidy
    [cable_management.scad]
2021-02-26 Base now compiles. Moved lugs slightly
    [microscope_stand.scad]
2021-02-26 Reworked lug code, added front lugs
    [main_body.scad]
2021-03-03 Fix band cutaway render
    [band_insertion_cutaway.scad]
2021-03-03 Update LED array holder to work with new dovetail
    I've also taken the liberty of tidying the indenting and
    removing some unused code.
    [LED_array_holder.scad]
2021-03-03 Restored old dovetail for reflection illuminator
    The reflection illuminator relies on the old dovetail module to work -
    I've changed the import so it is now fixed.
    [reflection_illuminator_LED_star.scad]
2021-03-03 fix reflection illuminator
    This uses the old dovetail module - this code could do with a clean
    but at least it works again for now.
    [reflection_illuminator.scad]
2021-03-04 Split render and geometry of cable tidies
    [cable_management.scad, cable_tidies.scad]
2021-03-04 Improve parameterisation
    [cable_tidies.scad]
2021-03-04 Started designing new base for microscope
    [main_body.scad, microscope_stand.scad]
2021-03-05 a basic pi housing
    [main_body.scad, microscope_stand.scad]
2021-03-05 New stand has space for pi tray
    [microscope_stand.scad]
2021-03-09 Switch render.sh to openscad_render.py wrapper
2021-03-10 Broke STL selector options into parseable functions
2021-03-12 Modify counterbores and screw holes in picam2_cutout picamera_2_camera_mount and lens_spacer
    picam2_cutout had the hole for self tapping built in.
    Remove and place as 'if-else' in the picamera_2_camera_mount module
    where it selects counterbores or not.
    Countebores redefined as r=1.15 not r=1 for No2 self-tap instead of M2
    lens_spacer has the counterbores re-asserted at the end as there was an overhang
    shelf protruduing into the counterbore from the convex hull making up the spacer.
    [lens_spacer.scad]
2021-03-13 Testing separate Z-axis of main body
    [main_body.scad]
2021-03-13 Remove transparency
    [lens_spacer.scad]
2021-03-13 Correct reference height for counterbores in lens spacer
    [lens_spacer.scad]
2021-03-13 Comments out build
    [lens_spacer.scad]
2021-03-13 Revert "Testing separate Z-axis of main body"
    This reverts commit 680da42da5eb14fef3658e3465c6050e024f67e0
    [main_body.scad]
2021-03-16 Port optics assembly camera to render.py
2021-03-16 Port optics assembly objective task to render.py
2021-03-16 Port optics assembly screw to render.py
2021-03-16 Fix path for render of optics assembly camera
2021-03-16 Fix missing assembly screw generate
2021-03-19 Created generic counterbore function for cameras, and tidied lens spacer
    [lens_spacer.scad]
2021-03-23 Fix camera position for picam disassembly
2021-03-23 Fix spelling of 'frame' variable
2021-03-25 Improve version string
    [main_body.scad]
2021-03-25 Fix bad merge
    [main_body.scad]
2021-03-25 Added illumination thumbscrew for new illumination
    [illumination_thumbscrew.scad]
2021-03-29 Consistent spaces (not tabs) for indent
    [electronics.scad, main_body.scad]
2021-03-29 Syntax consistentcy for actuator_assembly_tools.scad
    [actuator_assembly_tools.scad]
2021-03-29 Syntax consistentcy for camera_platform.scad
    [camera_platform.scad]
2021-03-29 Syntax consistentcy for feet.scad
    [feet.scad]
2021-03-29 Syntax consistentcy for fl_cube.scad
    [fl_cube.scad]
2021-03-29 Syntax consistency for a few small files
    [LED_array_holder.scad, large_gears.scad, lens_spacer.scad, lens_tool.scad]
2021-03-29 Syntax consistency for main_body.scad
    [main_body.scad]
2021-03-29 Syntax consistency for microscope_stand.scad
    [microscope_stand.scad]
2021-03-29 Syntax consistency for optics.scad
    [optics.scad]
2021-03-29 Syntax consistency for reflection_illuminator*.scad
    [reflection_illuminator.scad, reflection_illuminator_LED_star.scad]
2021-03-29 Syntax consistency for samle clips and slide riser
    [sample_clips.scad, slide_riser.scad]
2021-03-29 Syntax consistency for a number of small files
    [1_inch_disc_holder.scad, actuator_drilling_jig.scad, actuator_tension_band.scad, footprint_pocket.scad, footprint_with_holes.scad, small_gears.scad, thumbwheels.scad]
2021-03-29 Syntax consistency for endstop.scad
2021-03-29 Syntax consistency for gears and illumination
2021-03-29 Fix some typos
    [main_body.scad]
2021-03-29 Significant deduplication of code in threads.scad
2021-03-29 Syntax consistency for z_axis.scad
2021-03-29 Syntax consistency for most cameras
2021-03-29 Slight spacing changes in lens.scad
2021-03-29 Syntax consistency for self-tap test object
    [trylinder_selftap_holes_test.scad]
2021-03-29 Syntax consistency for rendering code
    [actuator_assembly.scad, band_insertion_cutaway.scad, brim_and_ties.scad, electronics.scad, hardware.scad, illumination_assembly.scad]
2021-03-29 Minor fixes
    [actuator_assembly_tools.scad, feet.scad, microscope_stand.scad, sample_clips.scad]
2021-03-29 remove trailing whitespace
    [LED_array_holder.scad, actuator_assembly.scad, band_insertion_cutaway.scad, cable_management.scad, cable_tidies.scad, electronics.scad, feet.scad, hardware.scad]
2021-03-29 Clarify names of zeroz and smatrix
    [actuator_assembly_tools.scad, feet.scad]
2021-03-29 Remove commented out code
    [microscope_stand.scad, optics.scad, slide_riser.scad]
2021-03-30 Simplifying z_translations
    [LED_array_holder.scad, actuator_assembly.scad, actuator_assembly_tools.scad, actuator_drilling_jig.scad, bottom_of_main_body.scad, cable_management.scad, camera_platform.scad, electronics.scad]
2021-03-30 Simplifying y_translations
    [LED_array_holder.scad, actuator_assembly_tools.scad, cable_tidies.scad, electronics.scad, feet.scad, fl_cube.scad, main_body.scad, microscope_stand.scad]
2021-03-30 Simplifying x_translations
    [actuator_assembly.scad, actuator_drilling_jig.scad, electronics.scad, hardware.scad, main_body.scad, microscope_stand.scad, reflection_illuminator.scad, reflection_illuminator_LED_star.scad]
2021-03-30 Simplifying x- y- and z- rotations
    [actuator_assembly.scad, actuator_assembly_tools.scad, band_insertion_cutaway.scad, cable_tidies.scad, feet.scad, fl_cube.scad, illumination_assembly.scad, microscope_stand.scad]
2021-03-30 Simplifying reflections
    [actuator_assembly_tools.scad, cable_management.scad, cable_tidies.scad, feet.scad, fl_cube.scad, hardware.scad, main_body.scad, microscope_stand.scad]
2021-03-31 Fix issues found by SCA2D
    [actuator_assembly_tools.scad, feet.scad, main_body.scad, reflection_illuminator.scad, reflection_illuminator_LED_star.scad]
2021-04-01 Reducing SCA2D warnings
    [LED_array_holder.scad, actuator_assembly.scad, band_insertion_cutaway.scad, bottom_of_main_body.scad, brim_and_ties.scad, cable_management.scad, illumination_assembly.scad, leg_test.scad]
2021-04-01 fix bug in z_axis
2021-04-01 Move microscope stand functions to library
    [footprint.scad, footprint_pocket.scad, footprint_with_holes.scad, microscope_stand.scad, microscope_stand_no_pi.scad, motor_driver_case.scad]
2021-04-02 Fixing cad test to same OpenSCAD version as build
2021-04-07 fix errors in render code
    [electronics.scad, optics.scad]
2021-04-07 De-duplicating positioning functions
    [assembly_parameters.scad]
2021-04-07 Remove excess semi-colons
    [LED_array_holder.scad, illumination_assembly.scad, optics.scad, reflection_illuminator_LED_star.scad]
2021-04-07 Removing globals from compact nut seat
    [actuator_assembly_tools.scad, feet.scad]
2021-04-07 Tidy up actuator tools
    [actuator_assembly.scad, actuator_assembly_tools.scad, band_insertion_cutaway.scad]
2021-04-07 Breaking optics into library
    [camera_platform.scad, optics.scad, reflection_illuminator.scad, reflection_illuminator_LED_star.scad, rms_optics_assembly.scad]
2021-04-08 No longer use optics global for RMS optics module
    [optics.scad, rms_optics_assembly.scad]
2021-04-08 Deduplicating optics fuctions and make lens spacer work without global
    [lens_spacer.scad]
2021-04-08 make optics configurable again
    [lens_spacer.scad, optics.scad]
2021-04-08 Remove endstop code
    [feet.scad]
2021-04-08 Fix camera platform for new optics, plus typos
    [camera_platform.scad, lens_spacer.scad, rms_optics_assembly.scad]
2021-04-08 Optics functions without global
    [camera_platform.scad, lens_spacer.scad, optics.scad, rms_optics_assembly.scad]
2021-04-08 Update build script
    [rms_optics_module.scad]
2021-04-08 Removing more globals
    [main_body.scad, microscope_stand.scad, motor_driver_case.scad]
2021-04-08 Make delta stage optics rotations configurable parameters
2021-04-08 feet_height in params, led_r moved to illumination
    [feet.scad]
2021-04-08 Removed the final global variables from microscpe_parameters.scad
    [fl_cube.scad, reflection_illuminator.scad, reflection_illuminator_LED_star.scad, slide_riser.scad]
2021-04-09 use `use` statments not `include`
    [LED_array_holder.scad, actuator_assembly_tools.scad, actuator_drilling_jig.scad, assembly_parameters.scad, feet.scad, fl_cube.scad, main_body.scad, reflection_illuminator.scad]
2021-04-09 Fixing broken imports from modules relying on chain importing via include
    [actuator_assembly_tools.scad, actuator_drilling_jig.scad, cable_management.scad, feet.scad]
2021-04-11 tidy up rendering
    [assembly_parameters.scad, band_insertion_cutaway.scad, brim_and_ties.scad, illumination_assembly.scad, optics_assembly.scad, prepare_picamera.scad, rms_optics_assembly.scad]
2021-04-11 removing globals from cameras
2021-04-11 Clean up globals in accessories and test pieces
    [actuator_drilling_jig.scad, actuator_tension_band.scad, bottom_of_main_body.scad, leg_test.scad, nut_trap_test.scad, trylinder_selftap_holes_test.scad]
2021-04-11 Clean up gearing code for clarity and efficnecy
    [large_gears.scad, small_gears.scad, thumbwheels.scad]
2021-04-11 refactored reflection illumination
    [fl_cube.scad, reflection_illuminator.scad, reflection_illuminator_LED_star.scad]
2021-04-11 Cleaned up globals in microscope stand code
    [motor_driver_case.scad]
2021-04-11 clean up remaining variable warnings
    [cable_tidies.scad, camera_platform.scad, condenser.scad, feet.scad, illumination_dovetail.scad, led_array_holder.scad, lens_spacer.scad, microscope_stand_no_pi.scad]
2021-04-12 fix minor issues with condenser and condenser assembly render
    [assembly_parameters.scad]
2021-04-13 Print the generated SCAD file in unit tests
2021-04-22 Adjust camera cover around screws and for connector space
    Closes #210
2021-04-25 Rendering the picamera cover during assembly, flipping the condenser lens
    Closes #211 #212
    [assembly_parameters.scad, optics.scad, optics_assembly.scad, rendered_components.scad, rms_optics_assembly.scad]
2021-04-26 OFI kits have pre-assembled LED in 3_illumination.md
2021-04-26 band insertion tool in 1_actuator_assembly.md
    * added warning that the band insertion tool only bends one way otherwise it may break.
    * consistent naming as "band insertion tool", not "O ring insertion tool" or ambiguous "insertion tool"
2021-04-26 Fix outer thread generation code. This was a bug from cleanup
2021-05-05 Modified actuator assembly
2021-05-05 Added instructions for optics assembly
2021-05-05 Minor fixes to optics assembly instructions
2021-05-05 Documented illumination assembly
2021-05-05 Add mounting instructions
2021-05-05 Use STL preview for all printed parts
2021-05-06 Remove modules for old stand and widen new stand
    [microscope_stand.scad]
2021-05-06 Add mounting points to stand and cutout for reflection optics
2021-05-07 Adjusted stand mounts and added sangaboard mounts/hole
    [microscope_stand.scad]
2021-05-07 modify pi_stand, trying 2 screws and 2 pins for pi
    [microscope_stand.scad]
2021-05-09 Fix front mount hole of pi_stand, reduce mounting nubs
2021-05-09 Adding pi to base render
    [electronics.scad, microscope_stand.scad]
2021-05-09 Made rendering of Pi4 more complete
    [electronics.scad]
2021-05-10 Rendering of Sangaboard and more complete stand assembly
    [electronics.scad, microscope_stand.scad]
2021-05-11 Start prototyping a plate to hold nano-sangaboard
    [microscope_stand.scad, motor_driver_case.scad, nano_converter_plate.scad]
2021-05-11 Mention oiling the actuator in the docs
    [actuator_assembly.scad, assembly_parameters.scad, tools.scad]
2021-05-19 Add tap holes into nano converter plate
    [microscope_stand.scad, nano_converter_plate.scad]
2021-06-25 Testing and work in progress
    [Testing.scad, Z-only with cable guides.scad, Z-only without cable guides.scad, Z-only.scad, Z-only_base.scad]
2021-06-28 Making wings of z_axis optional.
    [Z-only.scad]
2021-06-29 Removing experimentating files from repository
    [Z-only with cable guides.scad, Z-only without cable guides.scad]
2021-06-29 Adding a third nut trap and screw hole.
2021-06-30 Removing 3rd nut trap as repeated code
2021-06-30 Deleting test file
    [Z-only_base.scad]
2021-06-30 Version 4 of z-spacer
    [upright_z_spacer.scad]
2021-06-30 Adding rectangular/triangular switch to z-axis
2021-06-30 Rotated b.holes moved boring_holes mod. to z-axis.
    [upright_z_spacer.scad]
2021-06-30 Added rectangular conditional statement
    [Z-only.scad]
2021-06-30 Changing n. traps to bor. and scr. holes for rtg.
    [Z-only.scad]
2021-06-30 Making boring_radius adjustable
    [upright_z_spacer.scad]
2021-06-30 Making back boring holes vertical
2021-06-30 First version of an upright condenser and mount
    [condenser_and_mount_upright.scad]
2021-07-02 Creates a stand alone condenser
    [condenser_and_mount_upright.scad]
2021-07-02 Changing the angles of boring holes
2021-07-02 Add flags so condenser tube can be built without dovetail mounting
2021-07-05 Rotating front screw holes to minimise threading
    [upright_z_spacer.scad]
2021-07-05 Parameterising position of condenser on the mount
    [condenser_and_mount_upright.scad]
2021-07-05 Generating STL of corner of z_spacer
    [upright_z_spacer.scad]
2021-07-05 Generating STL of corner of Z-axis
    [Z-only.scad]
2021-07-05 Adapting cam. mount as an optics mount for upright
2021-07-05 Draft - testing different modules
    [condenser_and_mount_combined_upright.scad]
2021-07-05 Changing angles of nut traps in spacer
    [upright_z_spacer.scad]
2021-07-06 Increasing boring hole size for rectangular z-axis
    [Z-only.scad]
2021-07-06 Renaming file
    [condenser_upright.scad]
2021-07-06 Work in progress
    [condenser_work_in_progress.scad]
2021-07-06 Moving code between files
    [condenser_and_mount_combined_upright.scad, condenser_work_in_progress.scad]
2021-07-06 Adding smart brim to z-axis
    [Z-only.scad]
2021-07-06 Solution to error when slicing
    [condenser_and_mount_combined_upright.scad]
2021-07-07 Increasing radius of cylinders for rectangular top
    [upright_z_spacer.scad]
2021-07-07 Cylindrical cut-out in spacer for motor
    [upright_z_spacer.scad]
2021-07-07 Adding 1mm thickness to top of spacer
    [upright_z_spacer.scad]
2021-07-08 Fixing problem with use of hole_from_bottom
2021-07-08 Translating tidies so that they slice correctly.
    [cable_tidies.scad]
2021-07-09 Tidying up and adding more comments
    [condenser_and_mount_combined_upright.scad]
2021-07-09 Tidying up the code and including more comments.
    [upright_z_spacer.scad]
2021-07-09 Tidying up the code and adding more comments.
    [Z-only.scad]
2021-07-09 Improve nano-converter plate mounting
    [nano_converter_plate.scad]
2021-07-09 Shifting mounting screw hole vertically upwards.
    [condenser_and_mount_combined_upright.scad]
2021-07-11 Removing output of geometries
    [Z-only.scad, condenser_and_mount_combined_upright.scad, upright_z_spacer.scad]
2021-07-12 Added cripper for nano convertor plate
    [nano_converter_plate_gripper.scad]
2021-07-27 Renaming files and adding to build script.
    [upright_condenser_and_mount.scad, z_only.scad]
2021-07-27 Images for assembly instructions
2021-07-28 Adding photos to assembly instructions
2021-07-28 Creating upright geometries for build script
    [upright_condenser_and_mount.scad, upright_z_spacer.scad]
2021-07-28 Highering the screw shift in the condenser
    [upright_condenser_and_mount.scad, upright_z_spacer.scad]
2021-07-28 Fixing error with labelling of printed parts
2021-08-02 Adding photo of lens to assembly instructions.
2021-08-02 Finalising upright assembly instructions.
2021-08-06 Adding 30cm ribbon cable to electronics
2021-08-06 Changing Pi cable to 30cm
2021-08-09 Making changes to assembly instructions
2021-08-09 Adding photographs to assembly instructions
2021-08-11 Generating stl's for the 3 diff. height z-spacers
    [0.1mm_z_spacer.scad, 10mm_z_spacer.scad, 5mm_z_spacer.scad, upright_z_spacer.scad]
2021-08-12 Mainbody nut trap
2021-08-12 Remove unused definition of hole_r
2021-08-12 Tidied up counterbored holes
    I got confused by the existing code for the counterbored holes -
    it had separate holes for the screw shaft, the screw head, and access.
    I've combined these all into one module, which I think is neater.
2021-08-12 Fix missing params argument
    [upright_z_spacer.scad]
2021-08-12 Shift holes up 1.5mm, and tidy code
    Since we're making something symmetrical, I've "reflected"
    it rather than duplicating the code.
2021-08-17 Upright z-spacer change + build script correction
    [1mm_z_spacer.scad]
2021-08-17 Add (params) to upright_objective_fitting_cutout. Update build
    [upright_condenser_and_mount.scad]
2021-08-19 Increase stand height for nano sangaboard
    [microscope_stand.scad]
2021-08-19 Tidy and reimplement other stand versions
    [microscope_stand.scad, microscope_stand_no_pi.scad, pi_stand.scad]
2021-08-19 Fix build script and fix issues flagged by SCA2D
    [footprint.scad, footprint_with_holes.scad]
2021-09-14 Explictly defining self tapping holes.
    [nano_converter_plate.scad]
2021-09-20 Start to clean up upright_condenser_and_mount
    [upright_condenser_and_mount.scad]
2021-09-21 Tidy the LED access in condenser mount using hole_from_bottom
    [upright_condenser_and_mount.scad]
2021-09-22 Upright_condenser code cleanup
    [upright_condenser_and_mount.scad]
2021-09-22 code cleanup z_only.scad
    [z_only.scad]
2021-09-22 code cleanup upright_z_spacer.scad
    [upright_z_spacer.scad]
2021-09-22 code cleanup upright_z_spacer
    [upright_z_spacer.scad]
2021-09-28 Report exit code from STL check and allow failure on CI
2021-10-05 Put a smart brim on sample clips
    [sample_clips.scad]
2021-10-05 Update stl file names in the Gitbuilding instructions upright_printing.md
2021-10-05 Correct z-axis references withing upright build instructions
2021-10-06 correct link for upright z-axis in Update upright_printing.md
2021-10-14 Improve smart brim and use on more parts
    [cable_tidies.scad, condenser.scad, nano_converter_plate.scad, sample_clips.scad]
2021-10-26 Starting to impement render system based on openscad animation
    [actuator_assembly.scad]
2021-10-26 Moved all openscad rendering into new system
    [band_insertion_cutaway.scad, cable_management.scad, prepare_picamera.scad, rms_optics_assembly.scad]
2021-10-26 Fixing mesh issues with lens spacer wher spacer meets camera mount top
2021-10-26 Fix mesh issue with threads.
2021-11-04 Reduce duplicated code, clarify naming
    [upright_z_spacer.scad]
2021-11-04 Fix names and add comment
    [upright_z_spacer.scad]
2021-11-04 Clarify names and reorganise upright scad
    [10mm_z_spacer.scad, 1mm_z_spacer.scad, 5mm_z_spacer.scad, seperate_z_actuator.scad, upright_condenser.scad, z_only.scad]
2021-11-09 Some final renaming before merge. Docs still need some work before the next alpha
    [10mm_z_spacer.scad, 5mm_z_spacer.scad, upright_z_actuator_mount.scad, upright_z_actuator_mount_10mm_sample.scad, upright_z_actuator_mount_5mm_sample.scad]
2021-11-10 Removing extra use of smart brim from this branch
    [cable_tidies.scad, condenser.scad, nano_converter_plate.scad, sample_clips.scad]
2021-11-10 Fix import error for nano converter plate
    [nano_converter_plate.scad]
2021-11-11 Fix some missing links in documentation
    [electronics.yml]
2021-11-11 Clarify nut insertion in actuator assembly
2021-11-11 Add pi stand to print list
2021-11-11 Adding in some of Kaspar's suggestions to actuator assembly docs
2021-11-11 Add nut, lead screw assembly, and nut tool to cutaway render
    [assembly_parameters.scad, band_insertion_cutaway.scad, render_utils.scad]
2021-11-11 Add further images to actuator assembly
    [band_insertion_cutaway.scad]
2021-11-12 Render images for inserting nuts into stage
    [actuator_assembly.scad, assembly_parameters.scad, prepare_main_body.scad]
2021-11-14 Add renders for inserting nuts into illumination platform
    [assembly_parameters.scad, prepare_main_body.scad]
2021-11-18 More information on washers for lead screw assembly
2021-11-24 Refactor stand slightly to expose parameters for assembly. Render prepare stand.
    [assembly_parameters.scad, microscope_stand.scad, microscope_stand_no_pi.scad, pi_stand.scad, prepare_main_body.scad, prepare_stand.scad, render_settings.scad]
2021-11-24 Fix bug in assembly render
    [actuator_assembly.scad]
2021-11-25 Render optics attachment and fix name clashes
    [actuator_assembly.scad, assembly_parameters.scad, mount_optics.scad, prepare_main_body.scad, render_utils.scad, rms_optics_assembly.scad, tools.scad]
2021-11-26 Finish renders for mounting optics
    [mount_optics.scad, tools.scad]
2021-11-26 Clarify use of ball driver
2021-11-26 Added rendering of mounting the microscope
    [assembly_parameters.scad, microscope_stand.scad, mount_microscope.scad]
2021-12-02 Render condenser thumbscrew assembly and mounting illumination
    [assembly_parameters.scad, condenser_assembly.scad, illumination_assembly.scad, mount_illumination.scad, optics_assembly.scad, render_utils.scad]
2021-12-02 Precompiling main body stl for renders
    [brim_and_ties.scad, cable_management.scad, mount_microscope.scad, mount_optics.scad, optics_assembly.scad, prepare_main_body.scad, rendered_main_body.scad]
2021-12-07 Render attachment of the small gears
    [assembly_parameters.scad, cable_management.scad, electronics.scad, motor_assembly.scad]
2021-12-08 Add motor assembly to render.py
2021-12-13 Render mounting motors
    [assembly_parameters.scad, microscope_stand.scad, mount_illumination.scad, mount_motors.scad]
2021-12-15 Rendering pi drawer in and out with motor cables
    [assembly_parameters.scad, electronics.scad, microscope_stand.scad, motor_assembly.scad, mount_motors.scad]
2021-12-21 Rendering ribbon cable
    [assembly_parameters.scad, cable_management.scad, electronics.scad, mount_optics.scad, optics_assembly.scad, rms_optics_assembly.scad]
2021-12-21 Fix rendering of ribbon cable, tweak images in docs
    [rms_optics_assembly.scad]
2022-01-06 Adding more detail to the wiring section
2022-01-06 Fixing links and adding parts to library
    [mechanical.yml]
2022-01-06 Remove most m3x8 cap screws
2022-01-06 Remove trailing whitespace and unused imports
    [actuator_assembly_tools.scad, actuator_drilling_jig.scad, condenser.scad, fl_cube.scad, led_array_holder.scad, microscope_stand_no_pi.scad, nano_converter_plate.scad, nano_converter_plate_gripper.scad]
2022-01-06 Reduce expression complexity
    [sample_clips.scad]
2022-01-06 Remove unneeded import in pi_stand.scad
    [pi_stand.scad]
2022-01-12 Cutout for the illumination cable
    I've made a hole at the front of the Z cable tidy for the
    illumination cable.
    Doing this meant figuring out a bunch of the transforms.
    I have added comments as I went.
    I also needed to get the rendering working on my
    computer, and have added a README in case it helps
    others in the future.
    [cable_tidies.scad]
2022-01-12 Document LED wiring
    I've added instructions and an image to power the LED from
    the Sangaboard, and a work-around page describing
    powering the LED from the Pi. The latter is not part of
    the instructions for clarity.
2022-01-12 A note on the resistor, because why not.
2022-01-12 Add resistor why page to Pi workaround
2022-01-20 Pi 3 and Sangaboard v0.3 support in electronics tray
    [pi_stand.scad]
2022-01-20 Tweak sangaboard v0.3 connector positions for pi stand
2022-01-20 Generate all pi-stand versions, fix regression with nano convertor plate
    [pi_stand.scad]
2022-02-04 Pretty GitBuilding special blocks added, deduplicating things in upright
    [actuator_assembly.scad, band_insertion_cutaway.scad, upright_feet.scad, upright_large_gears.scad]
2022-02-04 Move soldering of LED to own page
2022-02-14 Add caution blocks for camera static warnings
2022-02-14 Rendering low cost optics
    [assembly_parameters.scad, lens_spacer.scad, low_cost_optics_assembly.scad]
2022-02-15 Low cost optics assembly render script and use in docs
    [assembly_parameters.scad, low_cost_optics_assembly.scad]
2022-02-16 Render of mounting low cost optics
    [assembly_parameters.scad, mount_optics.scad]
2022-02-16 Render all later assembly steps with low-cost and RMS optics
    [microscope_stand.scad, mount_illumination.scad, mount_microscope.scad, mount_motors.scad, mount_optics.scad]
2022-05-10 Fix build which was broken by a reorganisation of STL extras repository
2022-05-11 Added screws to retain small gear
    Removed bevels. Re-did the counterbore for the round section of the shaft
    so gear sits 1/2 mm above motor for the orientation we use in instructions.
    Gear height increased slightly to compensate.
    Tightened shaft hole on gear as it was very very loose on Prusa i3 Mk3.
    With splodgyer printers there may be a need to need press fit the gear
    with a clamp or vice. Tighter test prints (down to flat_shaft_w=3) on a
    Prusa i3 Mk3 press fitted well.
    The self-tapping screws go in for all sizes as they cut into the plastic
    this is intended to tighten the plastic keeping it well fitted in tension
    against the shaft. Holes are counterbored so that screwhead sits flush wit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
    [small_gears.scad]
2022-05-11 Update renders for mounting gears with screws
    [assembly_parameters.scad, motor_assembly.scad]
2022-05-11 Update GitBuilding instructions on how to attach motors
2022-05-12 Undercutting objective mount for elephants footing
    This is a bigger change than initially expected, due in part to some refactoring
    * Main structure for the objective mount now calculated more robustly based on the optics cutout for the centre of the microscope
    * Module created for the keyhole
    * Some refactoring (incomplete) of the fitting wedge to make it reusable
    * Refactoring of the fillets in the locking dovetail so they could be used here
    Closes #236
2022-05-13 Remove old use of lens gripper to work out cut in RMS optics module
2022-05-13 End the optics mounting keyhole in correct place for focus
2022-05-16 Modify access hole for objective screw allen key
2022-05-16 Improve parametrisation of Allen key position in renders
    [assembly_parameters.scad]
2022-05-18 Update instructions now we mount at top of keyhole
2022-05-19 Fix typo in file name
    Closes #246
    [separate_z_actuator.scad]
2022-05-23 Refactor optics module to implement changes from OFEP2
    * Distance from tube lens to objective is fixed
    * Camera position calculated in relation to tube lens, not just set
    * Infinite conjugates onjectives calculated exactly
    * Some parameters clarified
    * Calculations split out of main function into new scad file
    * fl_cube calculations moved out of lib_optics
2022-05-24 Fixed issues in reflection illumination introduced by refactor
    [fl_cube.scad, reflection_illuminator.scad]
2022-05-24 Refactor rms optics slightly and lengthen screw shaft hole
    [rms_optics_module.scad]
2022-07-18 Update instructions to new screw for optics module
    [microscope_stand.scad, rms_optics_assembly.scad]
2025-07-15 Add Chinese documentation and project architecture guides
    - Add comprehensive Chinese translations for assembly documentation
    - Main assembly guide (index_zh.md)
    - Bill of materials (0_bill_of_materials_zh.md)
    - Printing guide (0_printing_zh.md)
    - Actuator assembly (1_actuator_assembly_zh.md)
    - Basic optics module (2a_basic_optics_module_zh.md)
    - Illumination system (3_illumination_zh.md)
    - Navigation file (_navigation_zh.md)
    - Add project documentation for better understanding
    - Quick start guide (QUICK_START.md) - 5-minute project overview
    - Architecture documentation (ARCHITECTURE.md) - detailed technical guide
    - Enhanced README.md with project overview and Chinese do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
